brvdg/T25_cluster_fix/cluste_fix_board.JPG

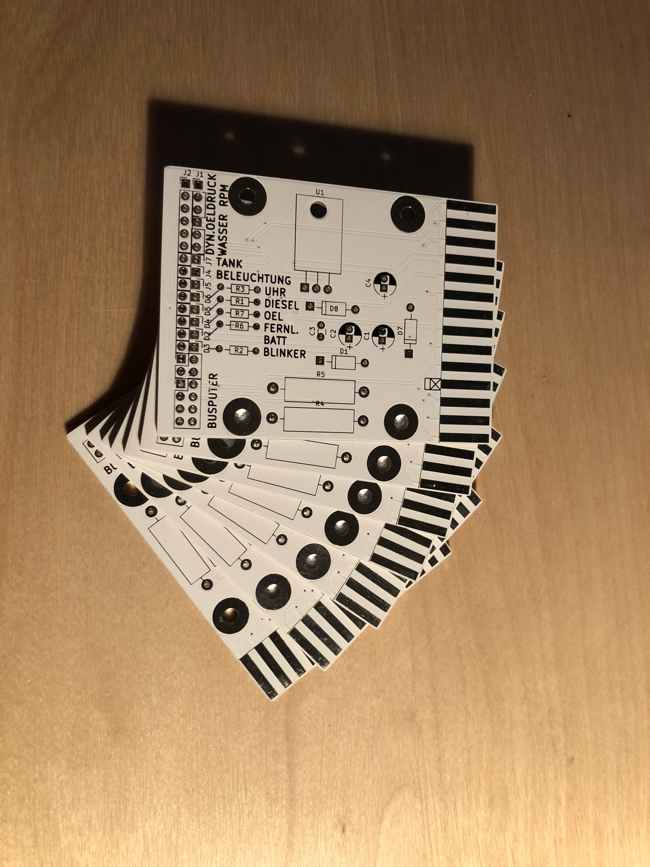
cluste_fix_board.JPG
