brvdg/T25_cluster_fix/README.md

# T25_cluster_fix

This is an replacement for brocken Volkswagen T25/Vanagon cluster foil.

For more informations see: https://fiz-o-matic.net/t3-ki-leiterfolie/
