brvdg/T25_cluster_fix/Leiterfolie_Gehäuse.stl

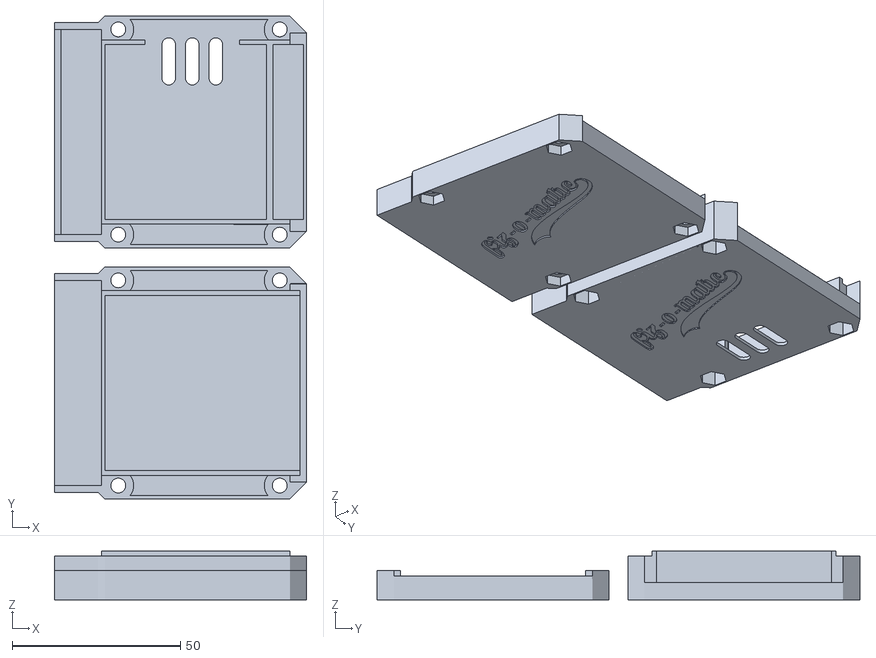
[picture p2: CAD file, 2019-10-07]
Leiterfolie_Gehäuse.stl
75.0 x 143.6 x 14.5
