brvdg/T25_cluster_fix/Leiterfolie.pdf

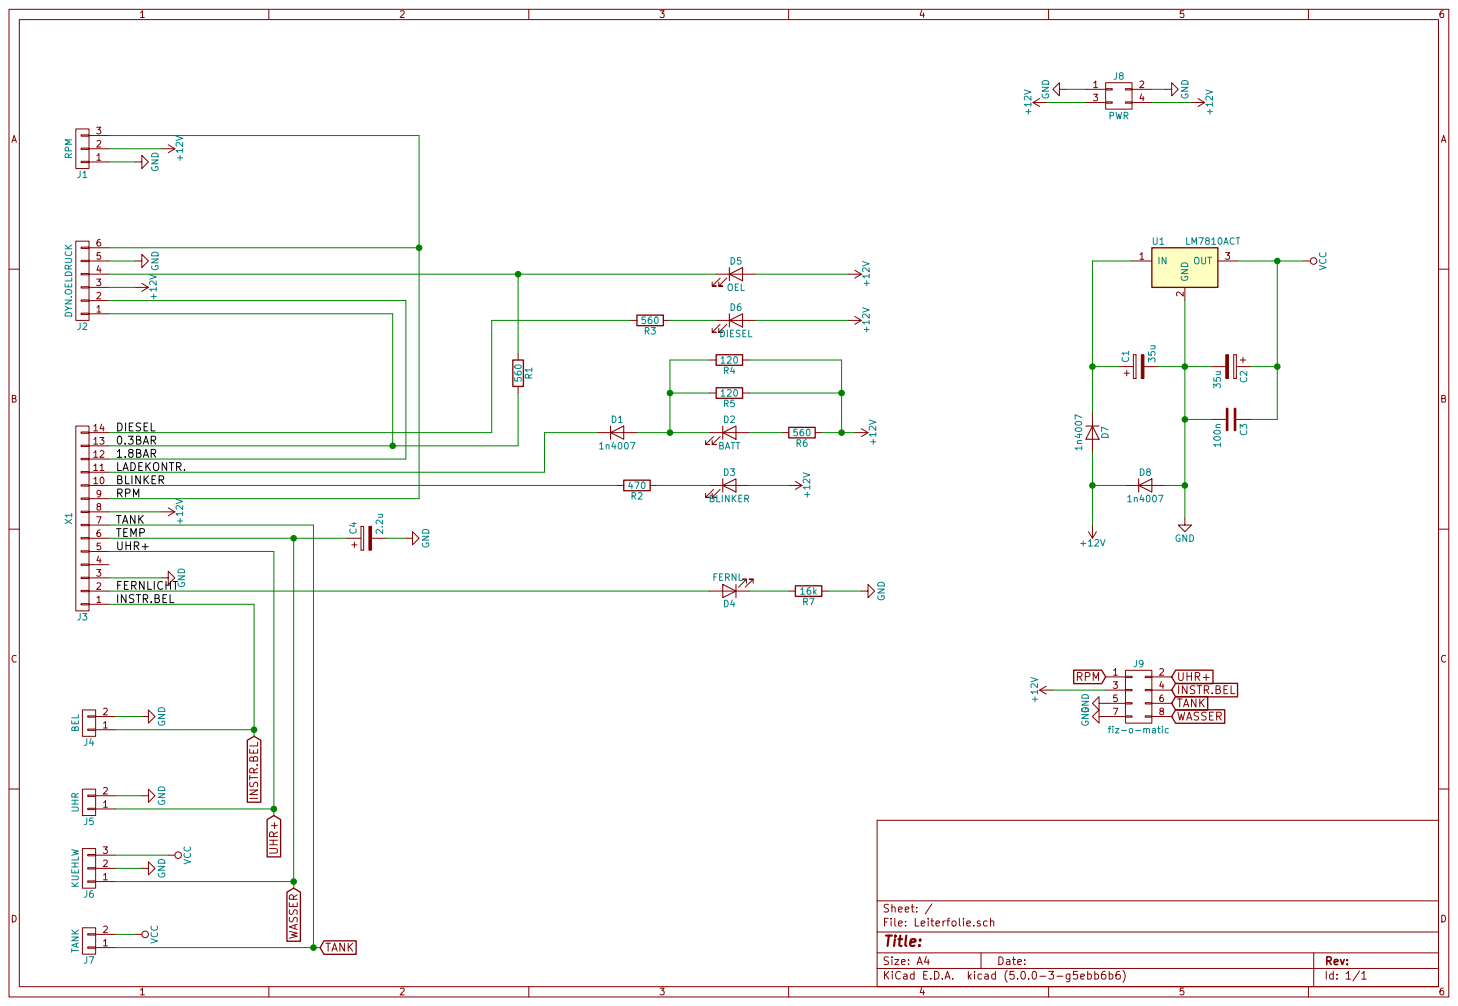
[picture p3: page 1]

1423456789 BLINKER
13 0.3BAR
12
11 | LADEKONTR.

DIESEL
INSTR.BEL 12
Id: 1/1 Title: File: Leiterfolie.sch Sheet: / 1
