brvdg/T25_cluster_fix/(commit log)

2018-10-28 Update Gerber_Files.zip
    adding gerber files
2018-12-30 updated gerber files
    [Leiterfolie-B.Cu.gbl, Leiterfolie-B.Mask.gbs, Leiterfolie-B.SilkS.gbo, Leiterfolie-Edge.Cuts.gm1, Leiterfolie-F.Cu.gtl, Leiterfolie-F.Mask.gts, Leiterfolie-F.SilkS.gto, Leiterfolie.drl]
